AtaberkOKLU/Noise_Level_Indicator_Analog_Circuit/README.md

"# Noise_Level_Indicator_Analog_Circuit"
