AtaberkOKLU/Noise_Level_Indicator_Analog_Circuit/(list of files, drawings)

Other design files:
Noise_Level_Indicator_Circuit.pdsprj
